loliamro/6V-Lead-Acid-Battery-Charger/simulation/final_regulator.asc

C1: cap; 100µ
C2: cap; 10µ
C3: cap; 10µ
D2: diode; UMZ5_1N
Q1: npn; 2SCR533P5
Q2: npn; 2SCR563F3
Q3: npn; 2SCR554P
R1: res; 430
R2: res; 430
R3: res; 220
R4: res; 430
R5: res; 0.5
R6: res; 470
R7: res; 100
RLoad: res; 20
Vin: voltage; 14; Rser=0.1
Named nets: 0
.dc Vin 10 30 0.1
.tran 1s
