loliamro/6V-Lead-Acid-Battery-Charger/simulation/phase1_regulator.asc

C1: cap; 100µ
C2: cap; 5µ
C3: cap; 5µ
D2: diode; UMZ5_1N
Q1: npn; 2SCR586D3
Q2: npn; 2SCR586J
Q3: npn; LS3250B
R1: res; 400
R2: res; 400
R3: res; 200
R4: res; 82
R5: res; 1
R6: res; 500
R7: res; 100
RLoad: res; 20
Vin: voltage; ""; Rser=0.1
Named nets: 0
.dc Vin 10 30 0.1
